adafruit/Adafruit-AS7331-UV-UVA-UVB-UVC-Sensor-PCB/Adafruit AS7331 UV UVA UVB UVC Sensor.brd

## EAGLE design Adafruit AS7331 UV UVA UVB UVC Sensor.brd (2026-03-05)

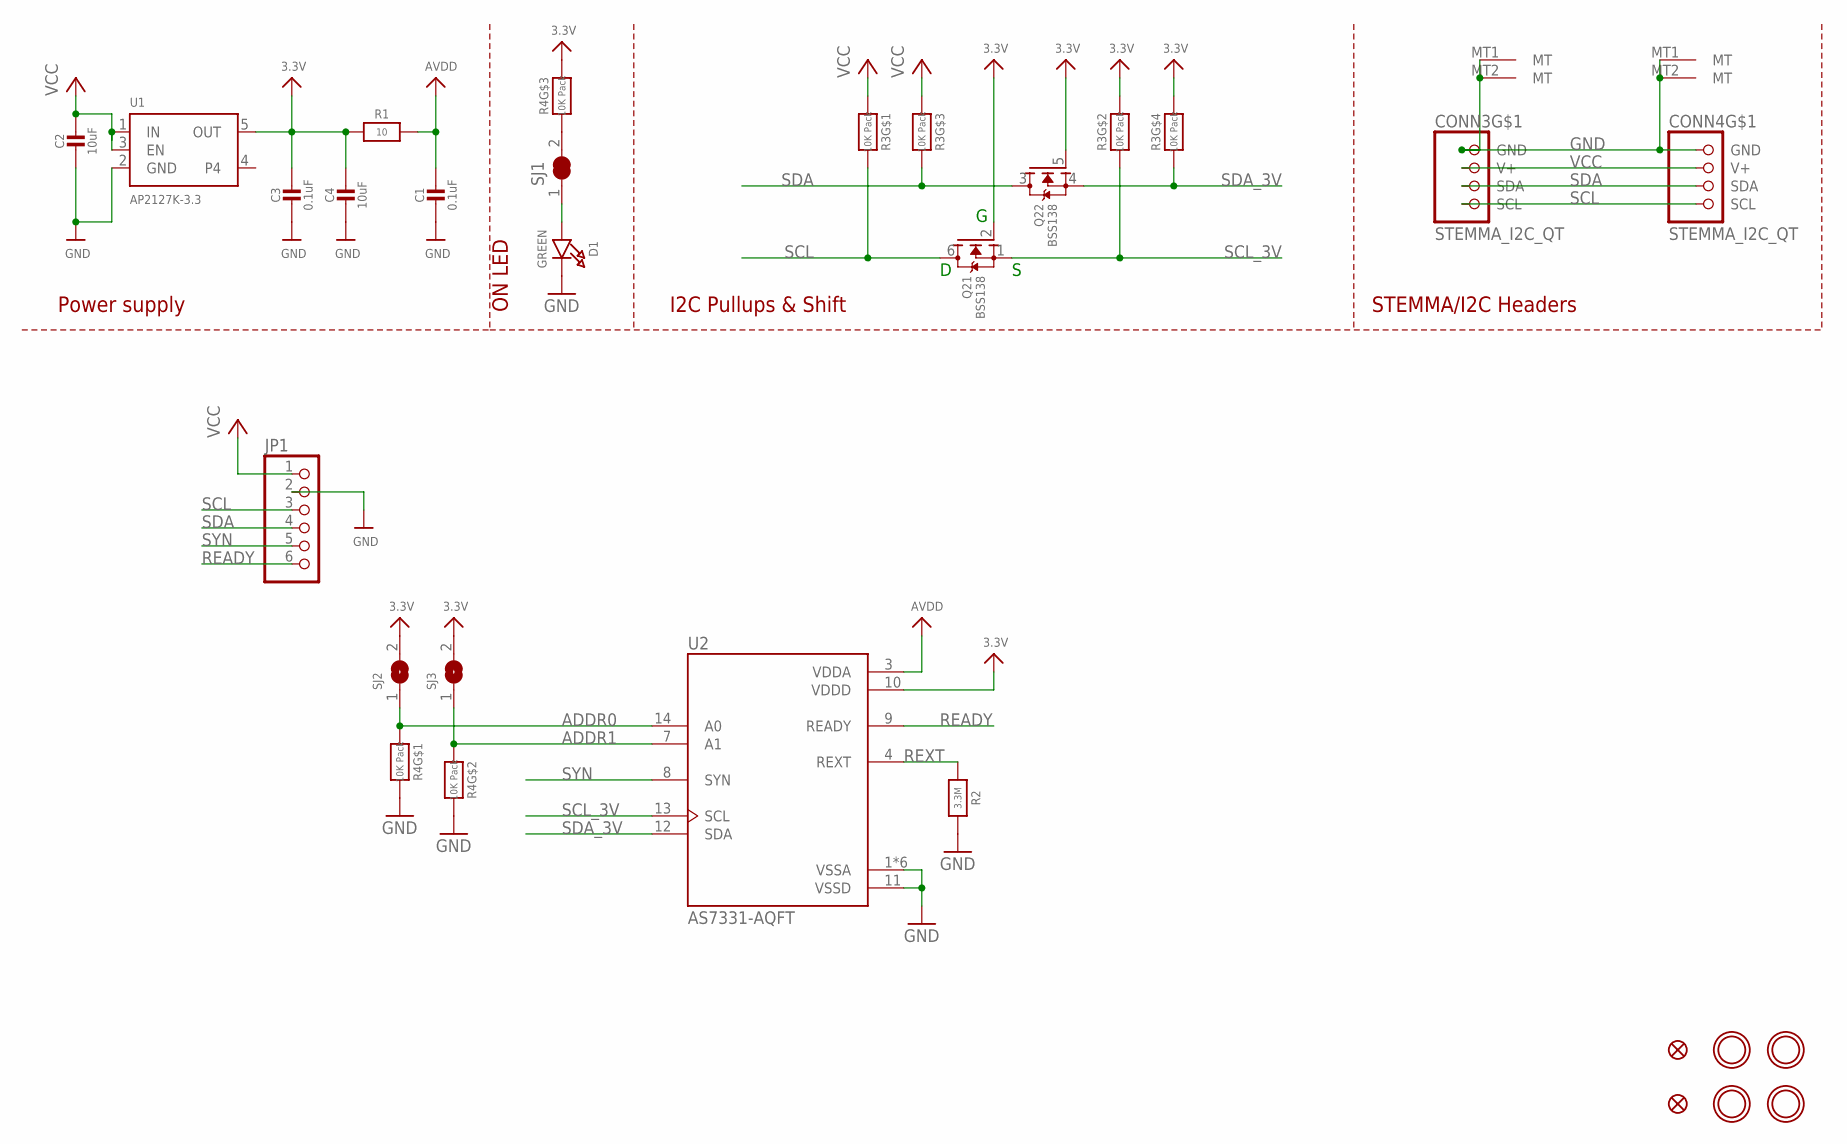
[picture p2: schematic Adafruit AS7331 UV UVA UVB UVC Sensor.sch]

Parts:
C1, C3: 0.1uF; 0603-NO
C2, C4: 10uF; 0805-NO
CONN3, CONN4: STEMMA_I2C_QT; JST_SH4
D1: GREEN; CHIPLED_0603_NOOUTLINE
FID3, FID4: FIDUCIAL_0.5MM
JP1: HEADER-1X670MIL; 1X06_ROUND_70
Q2: BSS138; SOT363
R1: 10; 0603-NO
R2: 3.3M; 0603-NO
R3, R4: 10K Pack; RESPACK_4X0603
SJ1: SOLDERJUMPER_CLOSED; SOLDERJUMPER_CLOSEDWIRE
SJ2, SJ3: SOLDERJUMPER; SOLDERJUMPER_ARROW_NOPASTE
U1: AP2127K-3.3; SOT23-5
U2: AS7331-AQFT; AS7331_SNAP
U$1, U$17, U$19, U$21: MOUNTINGHOLE2.5; MOUNTINGHOLE_2.5_PLATED

Connections:
3.3V: C3.1, C4.1, Q2.2 (G), Q2.5 (G), R1.1, R3.2 (1), R3.4 (1), R4.6 (2), SJ2.2, SJ3.2, U1.5 (OUT), U2.10 (VDDD)
ADDR0: R4.1, SJ2.1, U2.14 (A0)
ADDR1: R4.2 (1), SJ3.1, U2.7 (A1)
AVDD: C1.1, R1.2, U2.3 (VDDA)
GND: C1.2, C2.2, C3.2, C4.2, CONN3.1 (GND), CONN3.MT1 (MT), CONN3.MT2 (MT), CONN4.1 (GND), CONN4.MT1 (MT), CONN4.MT2 (MT), D1.C, JP1.2, R2.2, R4.7 (2), R4.8 (2), U1.2 (GND), U2.1 (VSSA), U2.2 (VSSA), U2.5 (VSSA), U2.6 (VSSA), U2.11 (VSSD), U2.15 (VSSA), U2.16 (VSSA)
unnamed: D1.A, SJ1.1
unnamed: R4.3 (1), SJ1.2
READY: JP1.6, U2.9 (READY)
REXT: R2.1, U2.4 (REXT)
SCL: CONN3.4 (SCL), CONN4.4 (SCL), JP1.3, Q2.6 (D), R3.8 (2)
SCL_3V: Q2.1 (S), R3.7 (2), U2.13 (SCL)
SDA: CONN3.3 (SDA), CONN4.3 (SDA), JP1.4, Q2.3 (D), R3.6 (2)
SDA_3V: Q2.4 (S), R3.5 (2), U2.12 (SDA)
SYN: JP1.5, U2.8 (SYN)
VCC: C2.1, CONN3.2 (V+), CONN4.2 (V+), JP1.1, R3.1, R3.3 (1), U1.1 (IN), U1.3 (EN)

Notes on the sheet:
I2C Pullups & Shift
STEMMA/I2C Headers
ON LED
Power supply

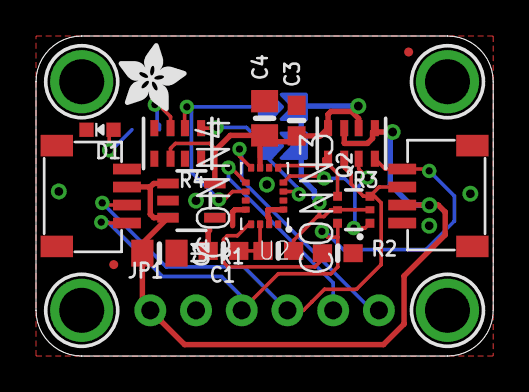
[picture p3: board Adafruit AS7331 UV UVA UVB UVC Sensor.brd from above]

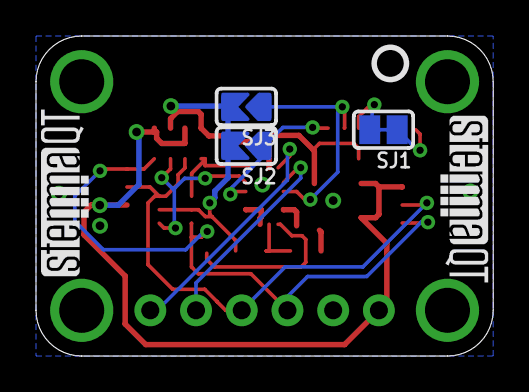
[picture p4: board Adafruit AS7331 UV UVA UVB UVC Sensor.brd from below]

Board: 2 copper layers, 25.4 x 17.8 mm, 45 parts (13 on the bottom side), 15 nets.

Other parts of the board:
PLABEL0: PLABEL0
PLABEL1: PLABEL1
PLABEL2: PLABEL2
PLABEL3: PLABEL3
PLABEL8: PLABEL8
PLABEL11: PLABEL11
PLABEL14: PLABEL14
PLABEL15: PLABEL15
PLABEL16: PLABEL16
PLABEL17: PLABEL17
PLABEL18: PLABEL18
PLABEL19: PLABEL19
PLABEL20: PLABEL20
PLABEL21: PLABEL21
PLABEL22: PLABEL22
PLABEL23: PLABEL23
PLABEL24: PLABEL24
U$22: ADAFRUIT_3.5MM
U$25: PCBFEAT-REV-040
U$30, U$31: STEMMAQT
